Kwan-Lab/behavioral-rigs/photos/lickometer/lickometer complete assembly2.png

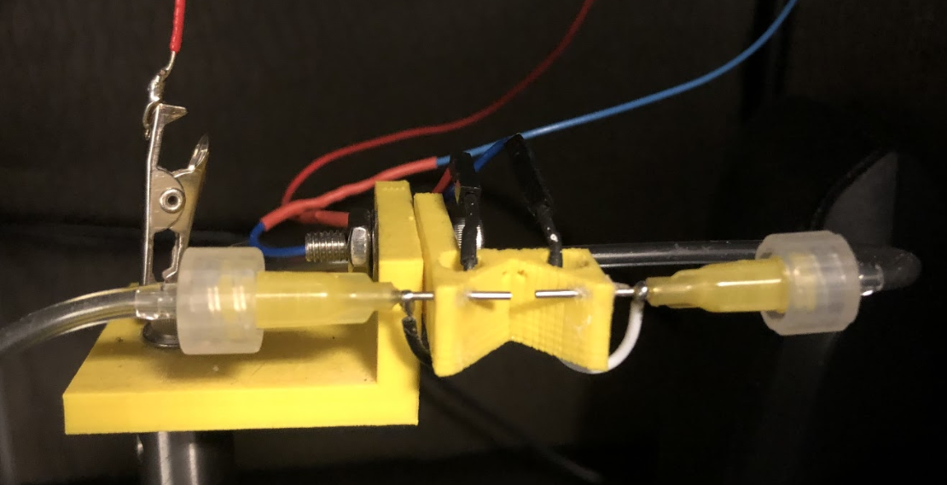
photos/lickometer/lickometer complete assembly2.png
