Kwan-Lab/behavioral-rigs/photos/lickometer/lickometer complete assembly.JPG

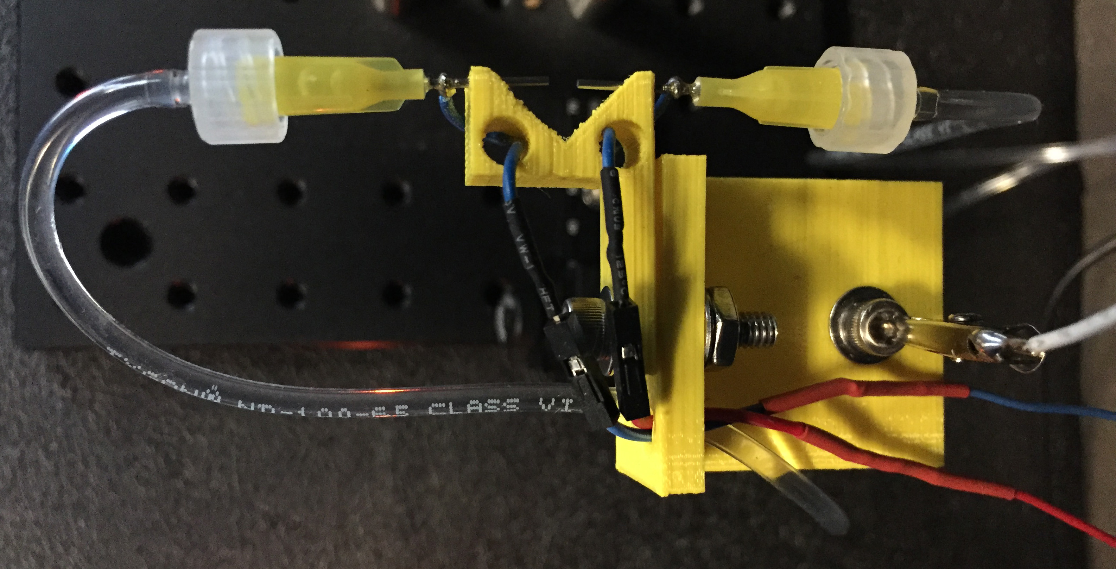
photos/lickometer/lickometer complete assembly.JPG
