Kwan-Lab/behavioral-rigs/README.md

# behavioral-rigs

This repository contains all the files needed to build a behavioral rig to train head-fixed mice for a two-choice decision-making task.
