Kwan-Lab/behavioral-rigs/photos/overview.pptx

Computer

Computer

Fluid
supply

USB-205
DAQ

USB-201
DAQ #2

USB-201
DAQ #1

USB-201
DAQ #3

Arduino

Solenoid
valves

Fluid delivery circuit

Lick
detection circuit

9V
battery

Steering
wheel

Lickometer

Grounding
clips

Pupil camera

Soundproof cabinet
