Kwan-Lab/behavioral-rigs/code/MATLAB pupil/Examples/daq/demo_clocked_dio/tmp102.png

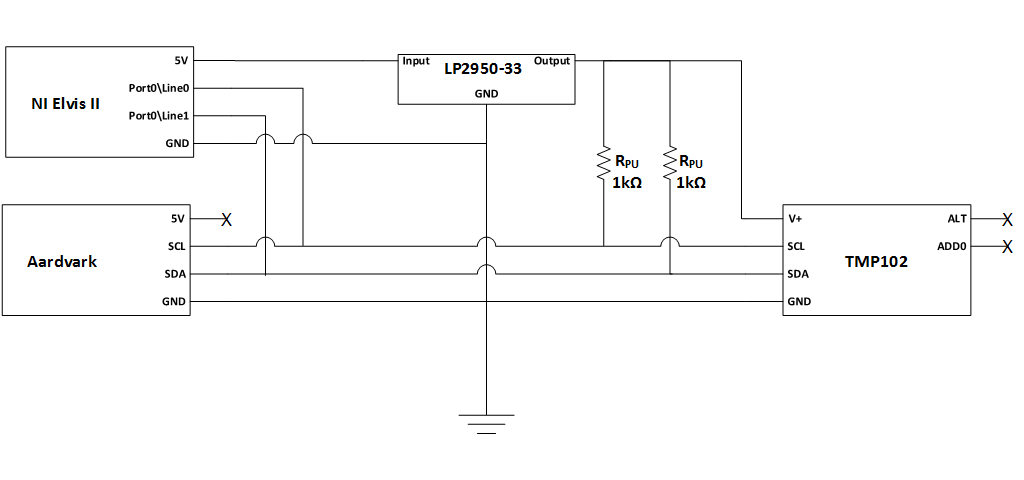
code/MATLAB pupil/Examples/daq/demo_clocked_dio/tmp102.png
