Kwan-Lab/behavioral-rigs/headplate/headplate1_small_window.jpg

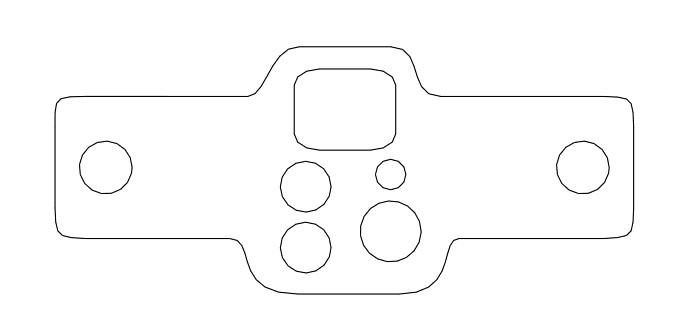
headplate/headplate1_small_window.jpg
