Kwan-Lab/behavioral-rigs/headplate/headplate2_standard.jpg

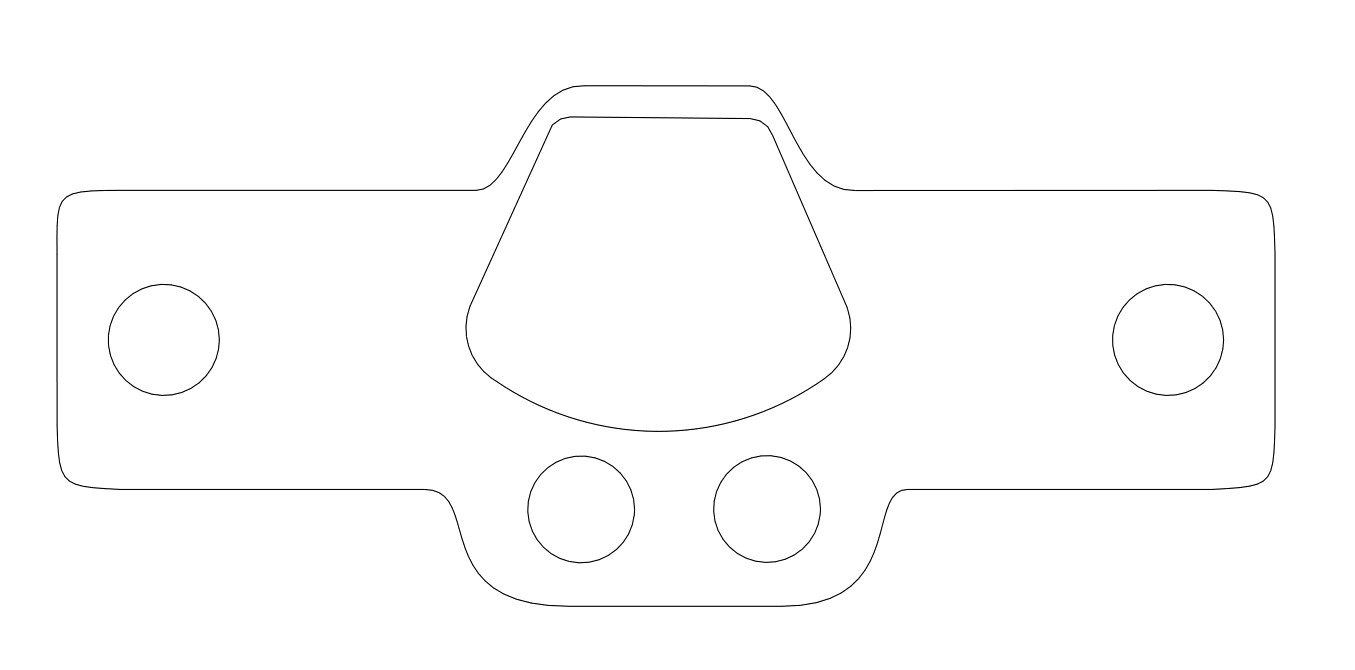
headplate/headplate2_standard.jpg
