Kwan-Lab/behavioral-rigs/headplate/headplate3_small_window_aligned.jpg

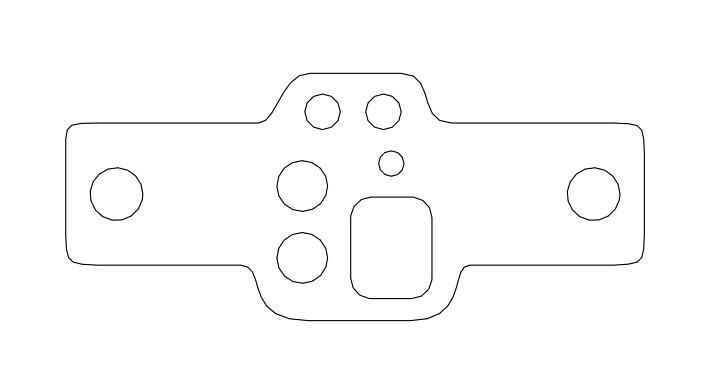
headplate/headplate3_small_window_aligned.jpg
