Kwan-Lab/behavioral-rigs/headplate/headplate4_wholecortex.jpg

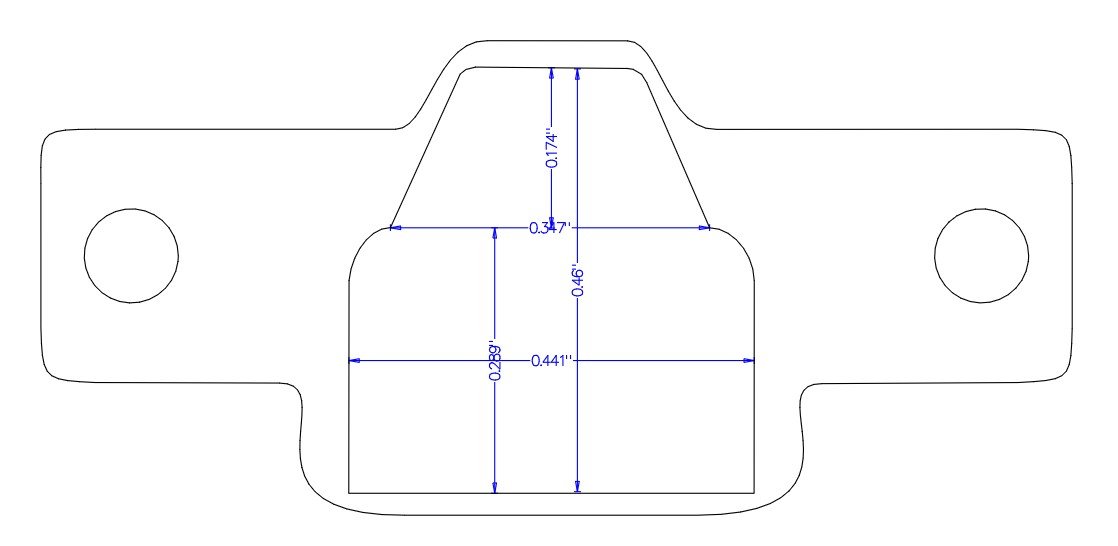
headplate/headplate4_wholecortex.jpg
