Kwan-Lab/behavioral-rigs/headplate/holder.jpg

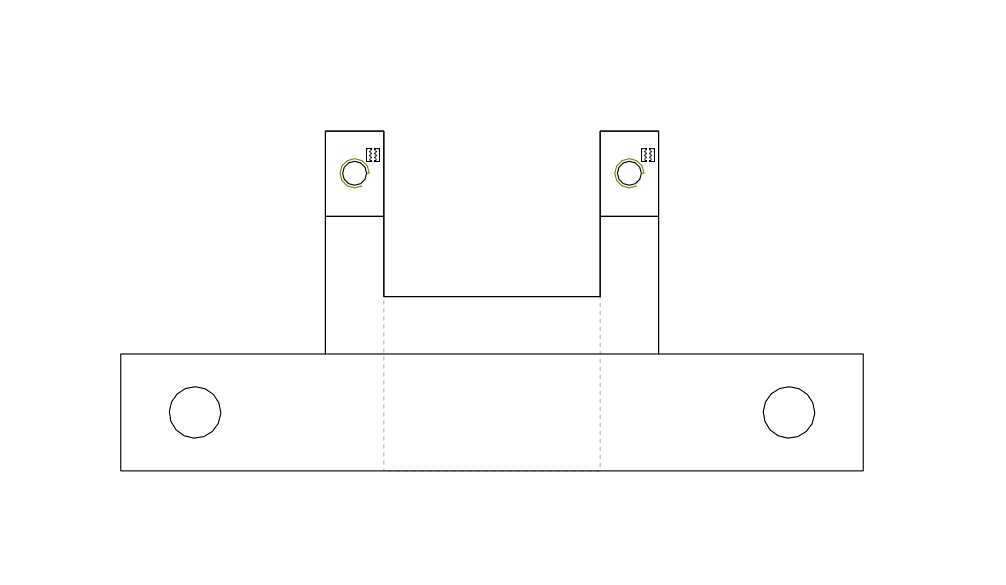
headplate/holder.jpg
