Kwan-Lab/behavioral-rigs/photos/box inside.JPG

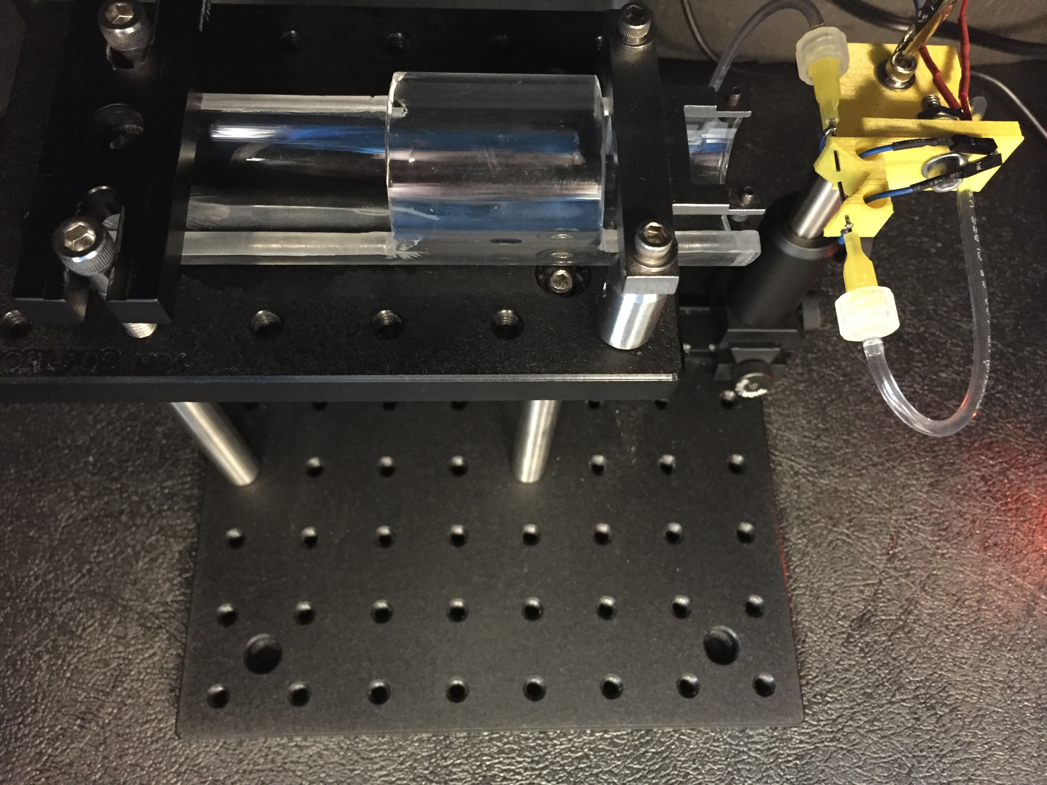
photos/box inside.JPG
