Kwan-Lab/behavioral-rigs/photos/box outside.JPG

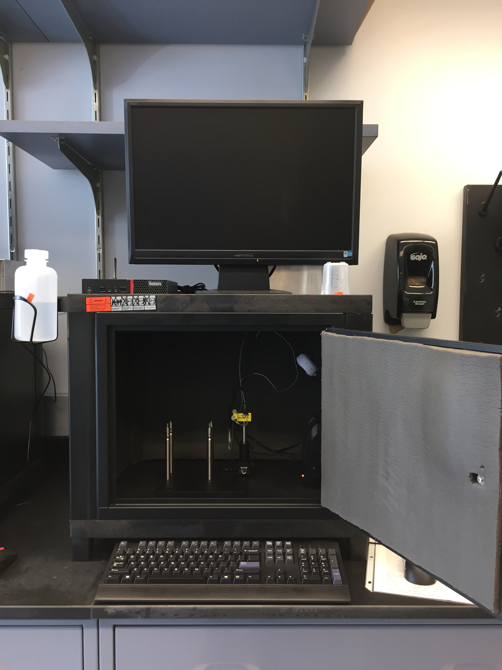
photos/box outside.JPG
