Kwan-Lab/behavioral-rigs/photos/cabinet/cabinet.JPG

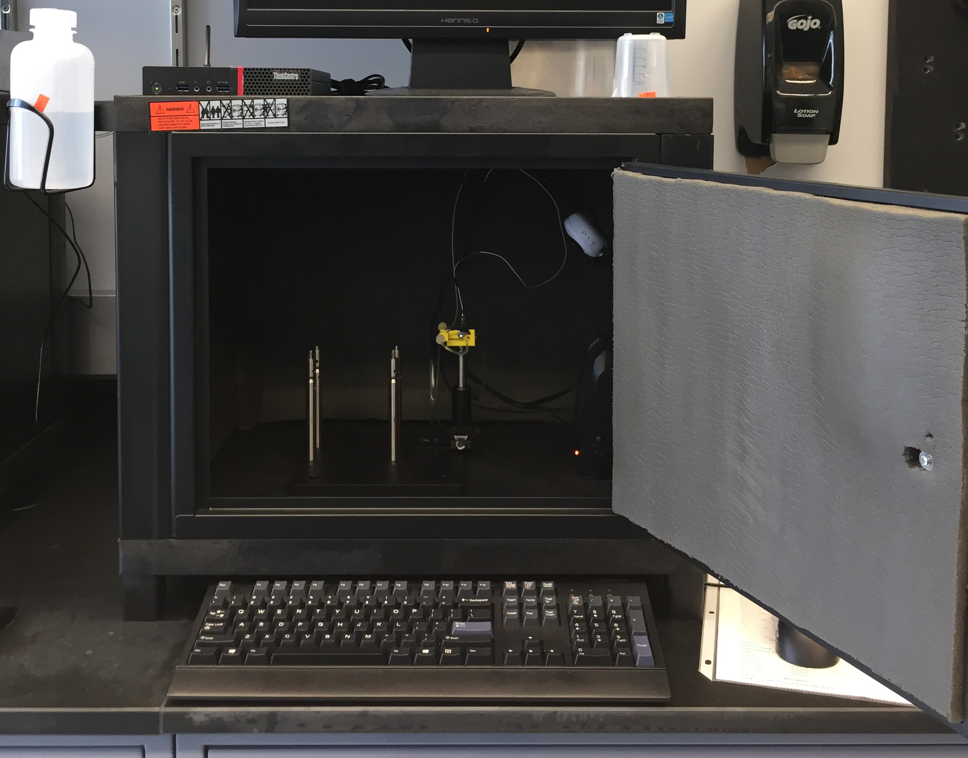
photos/cabinet/cabinet.JPG
