Kwan-Lab/behavioral-rigs/photos/cabinet/cart.png

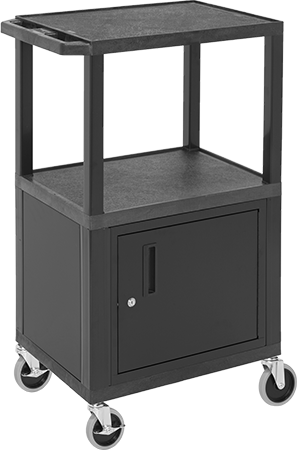
photos/cabinet/cart.png
