Kwan-Lab/behavioral-rigs/photos/computer control/camera.JPG

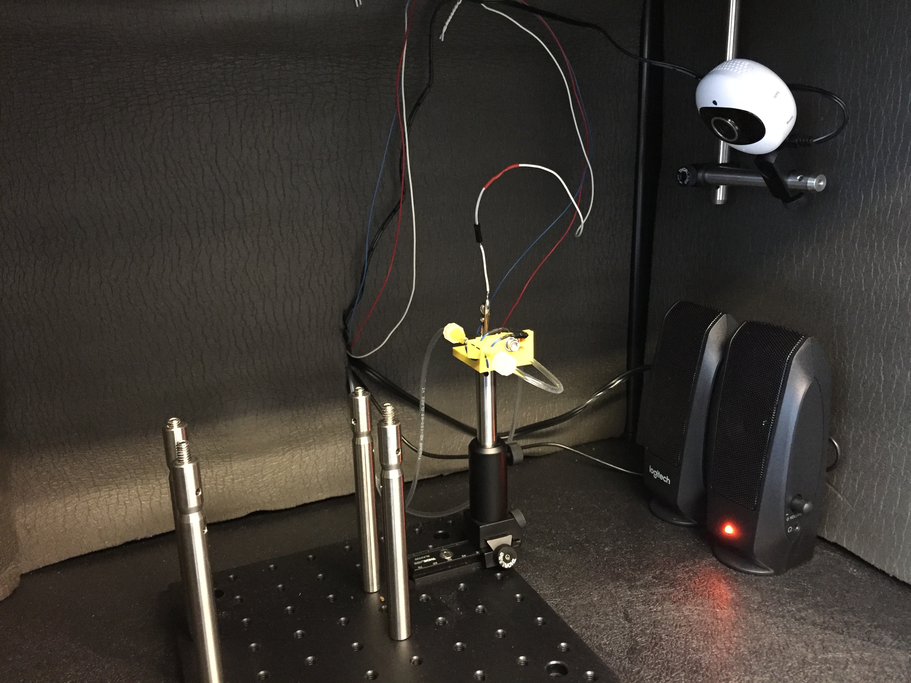
photos/computer control/camera.JPG
