Kwan-Lab/behavioral-rigs/photos/head fixation/acrylic.JPG

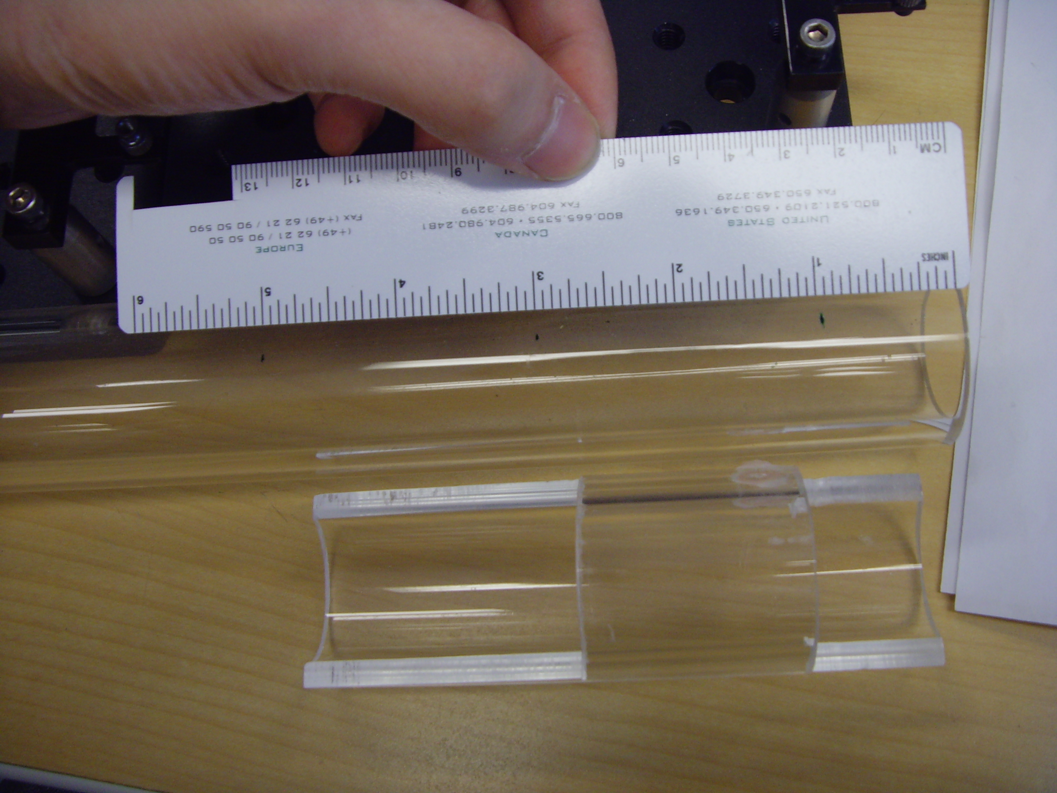
photos/head fixation/acrylic.JPG
