Kwan-Lab/behavioral-rigs/photos/head fixation/base empty.JPG

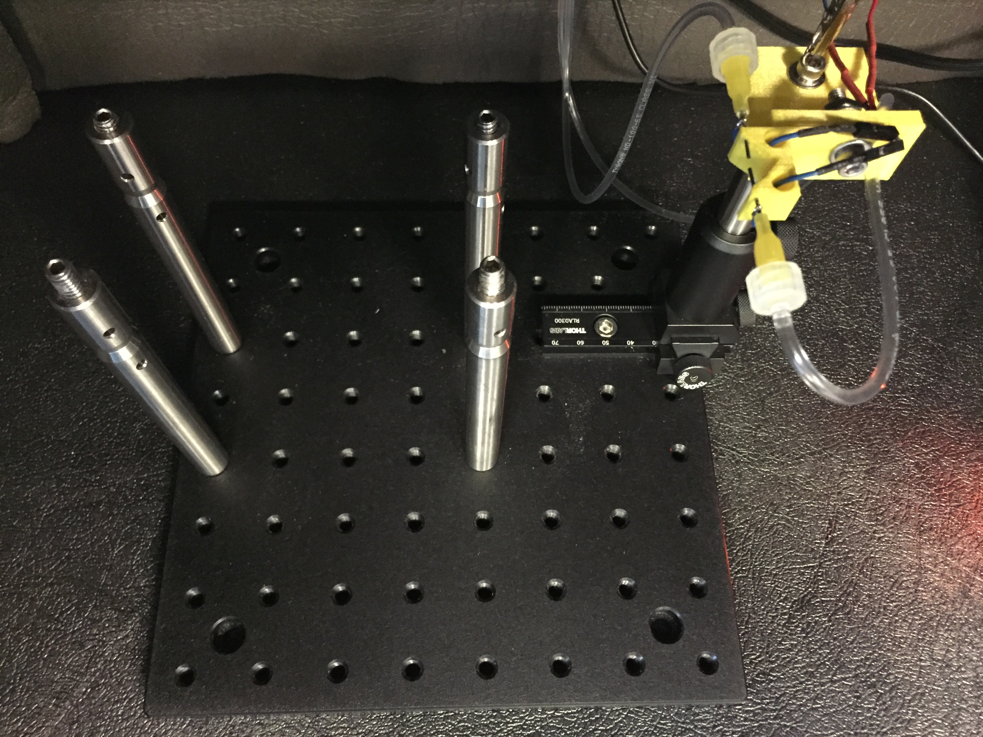
photos/head fixation/base empty.JPG
