Kwan-Lab/behavioral-rigs/photos/head fixation/headfixed front view.JPG

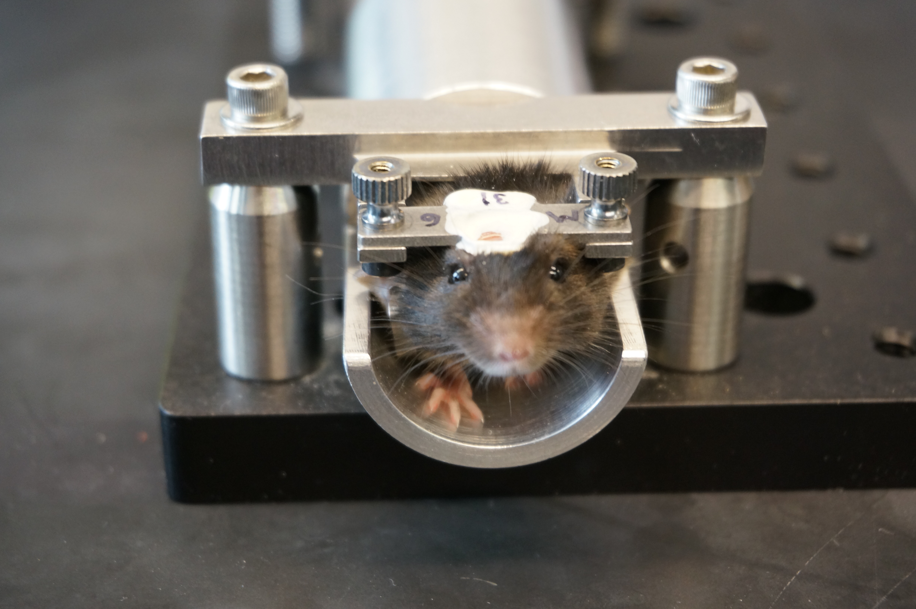
photos/head fixation/headfixed front view.JPG
