Kwan-Lab/behavioral-rigs/photos/head fixation/headfixed iso view.JPG

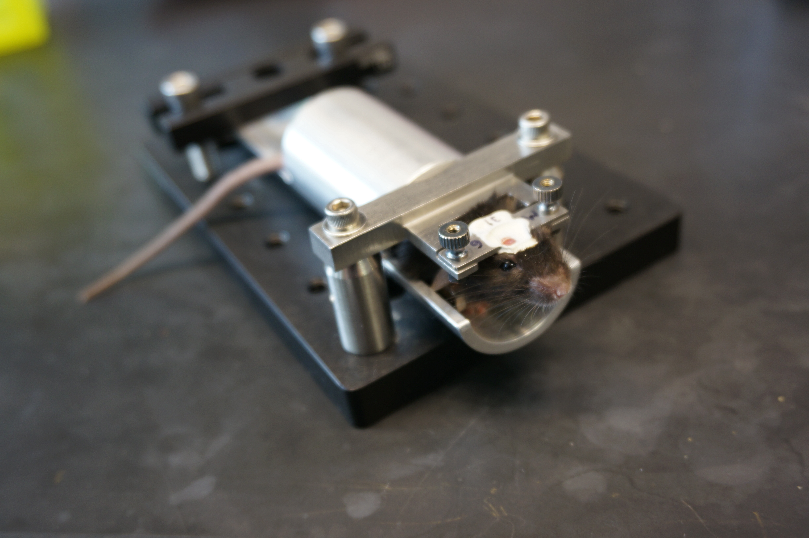
photos/head fixation/headfixed iso view.JPG
