Kwan-Lab/behavioral-rigs/photos/head fixation/headfixed top view.JPG

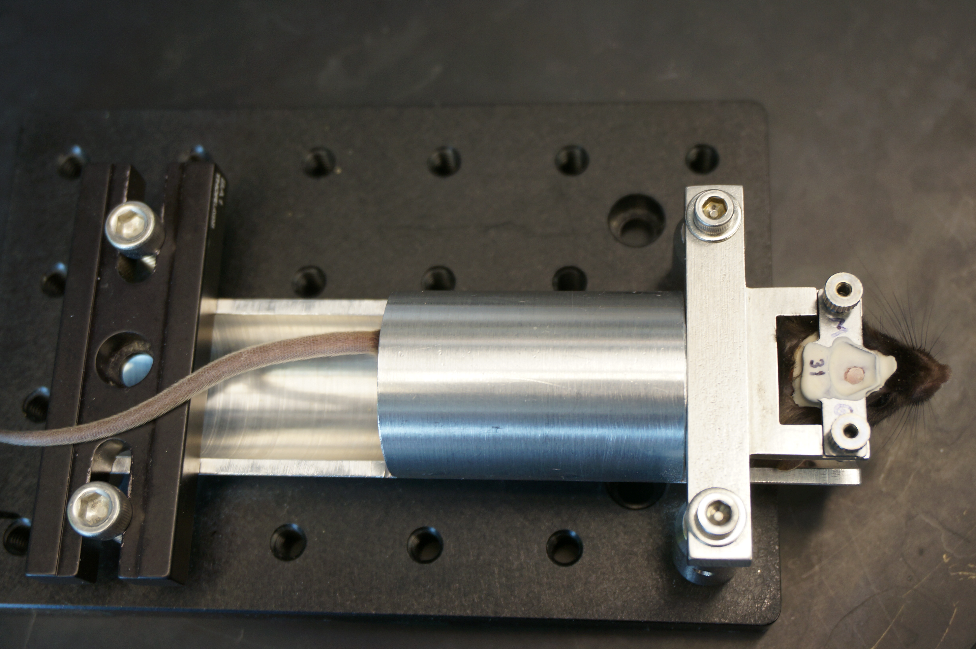
photos/head fixation/headfixed top view.JPG
