Kwan-Lab/behavioral-rigs/photos/lickometer/enclosure.JPG

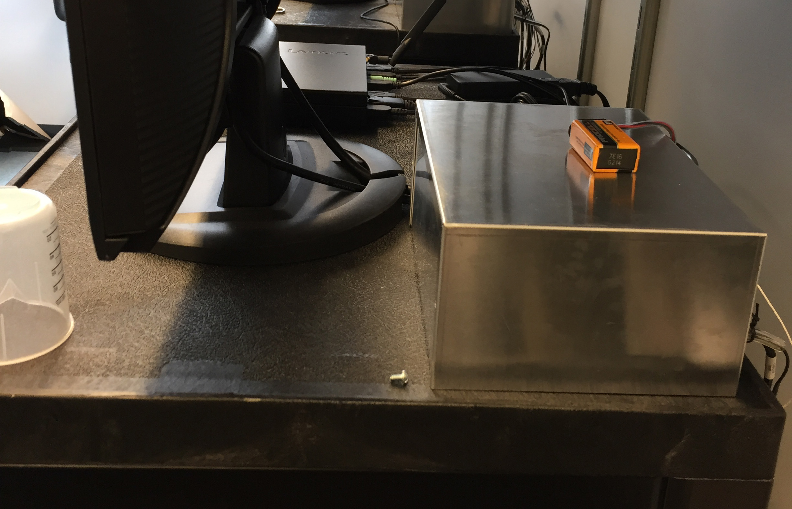
photos/lickometer/enclosure.JPG
