Kwan-Lab/behavioral-rigs/photos/lickometer/pcb lick-detector.jpg

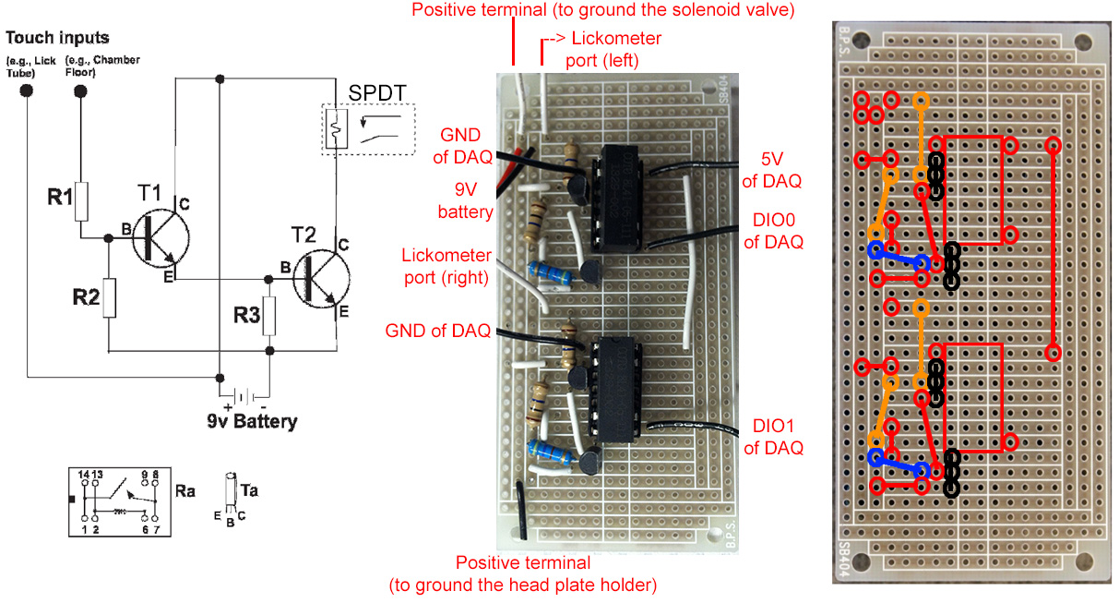
photos/lickometer/pcb lick-detector.jpg
