Kwan-Lab/behavioral-rigs/photos/lickometer/pcb solenoid-driver.jpg

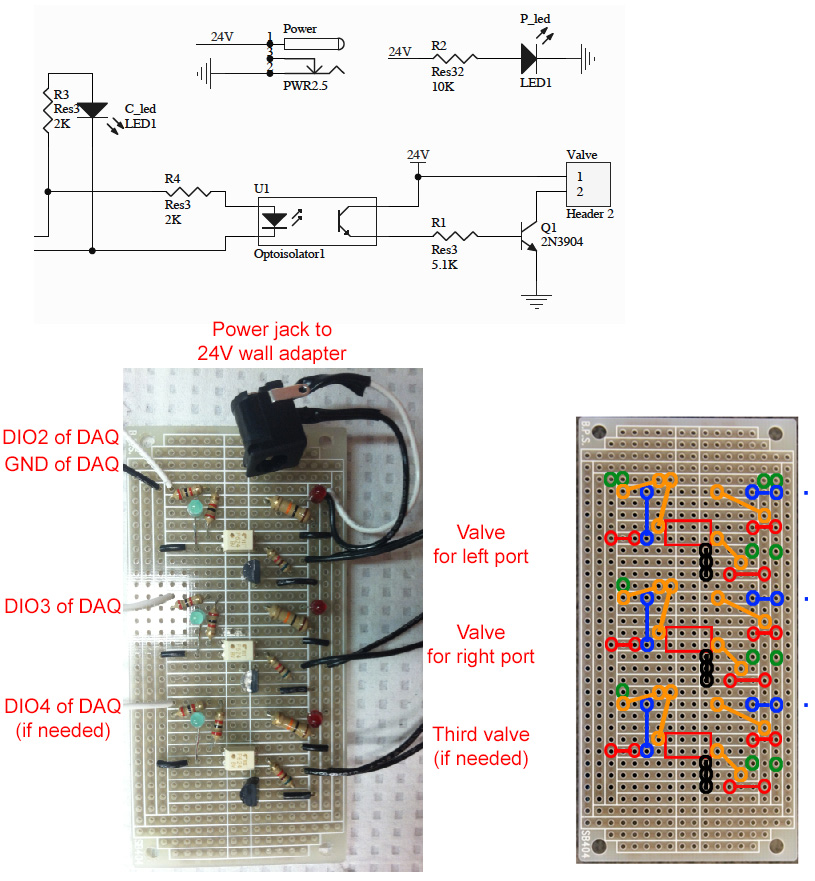
photos/lickometer/pcb solenoid-driver.jpg
