Kwan-Lab/behavioral-rigs/photos/lickometer/valve driver board.jpg

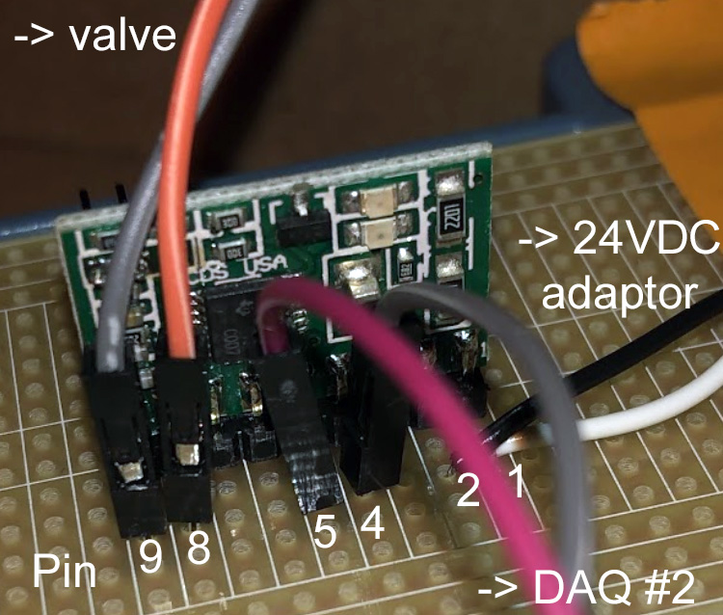
photos/lickometer/valve driver board.jpg
