Kwan-Lab/behavioral-rigs/photos/lickometer/valves.png

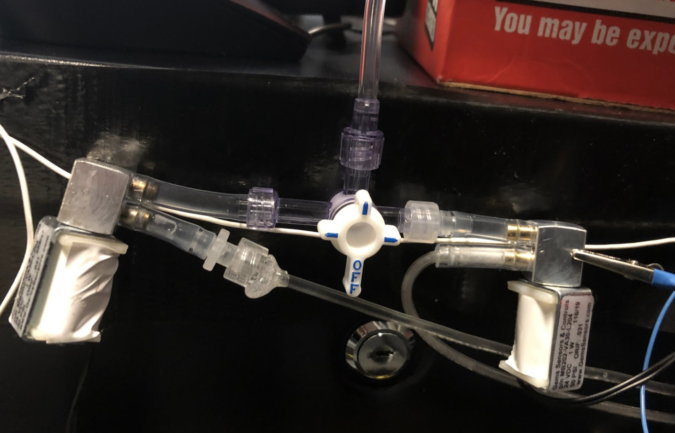
photos/lickometer/valves.png
