Kwan-Lab/behavioral-rigs/photos/lickometer/wire alligator.png

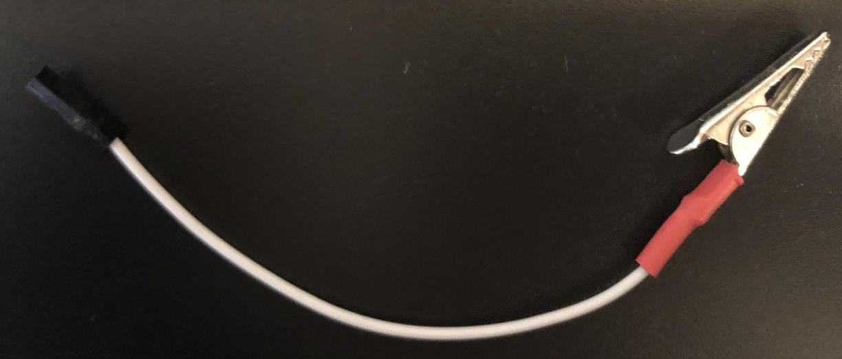
photos/lickometer/wire alligator.png
