Kwan-Lab/behavioral-rigs/photos/lickometer/wire syringe needle.png

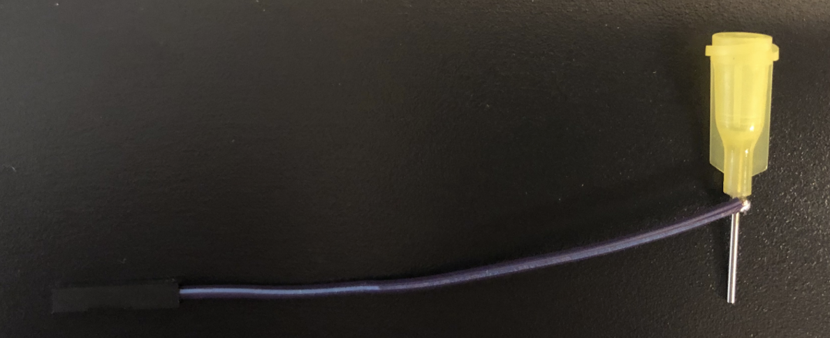
photos/lickometer/wire syringe needle.png
