Kwan-Lab/behavioral-rigs/photos/overview.png

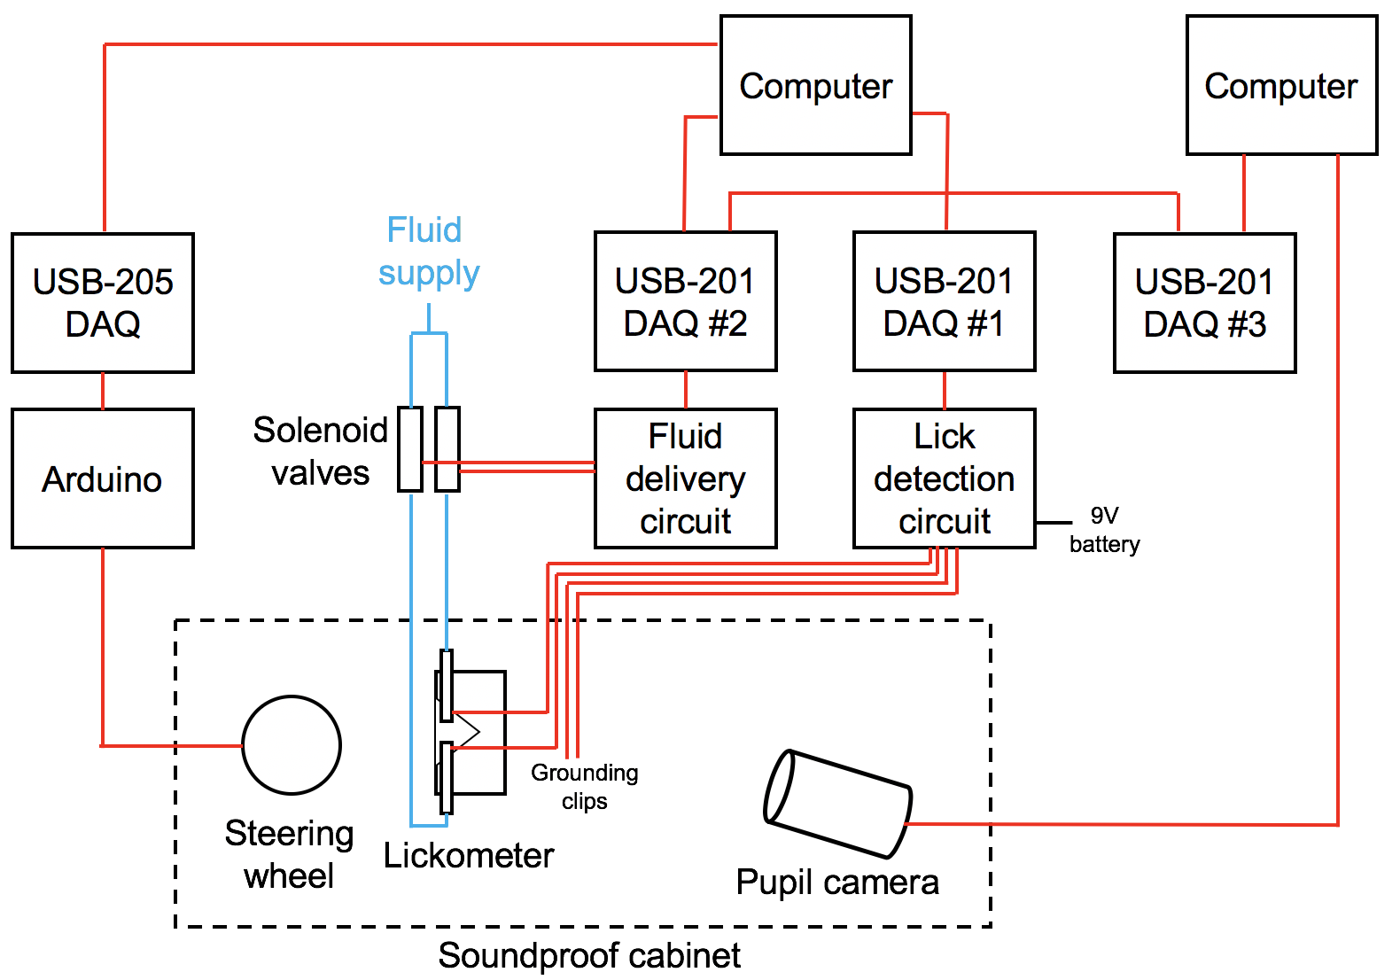
photos/overview.png
