Kwan-Lab/behavioral-rigs/photos/pupillometry/camera1.png

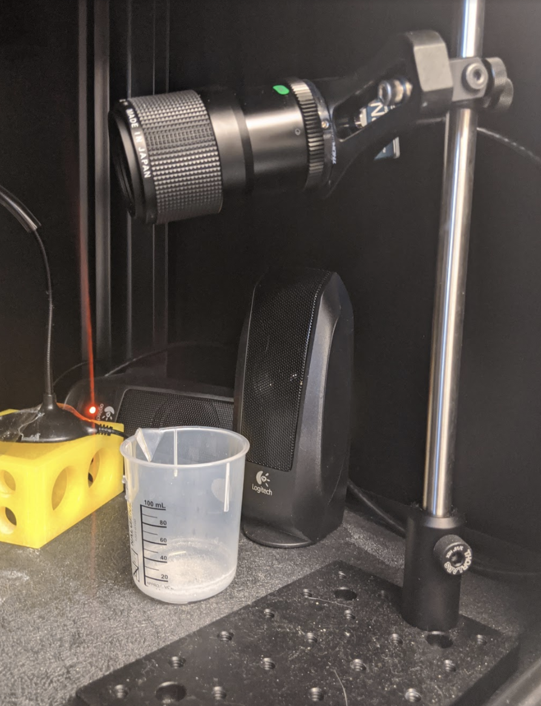
photos/pupillometry/camera1.png
