Kwan-Lab/behavioral-rigs/photos/pupillometry/camera2.png

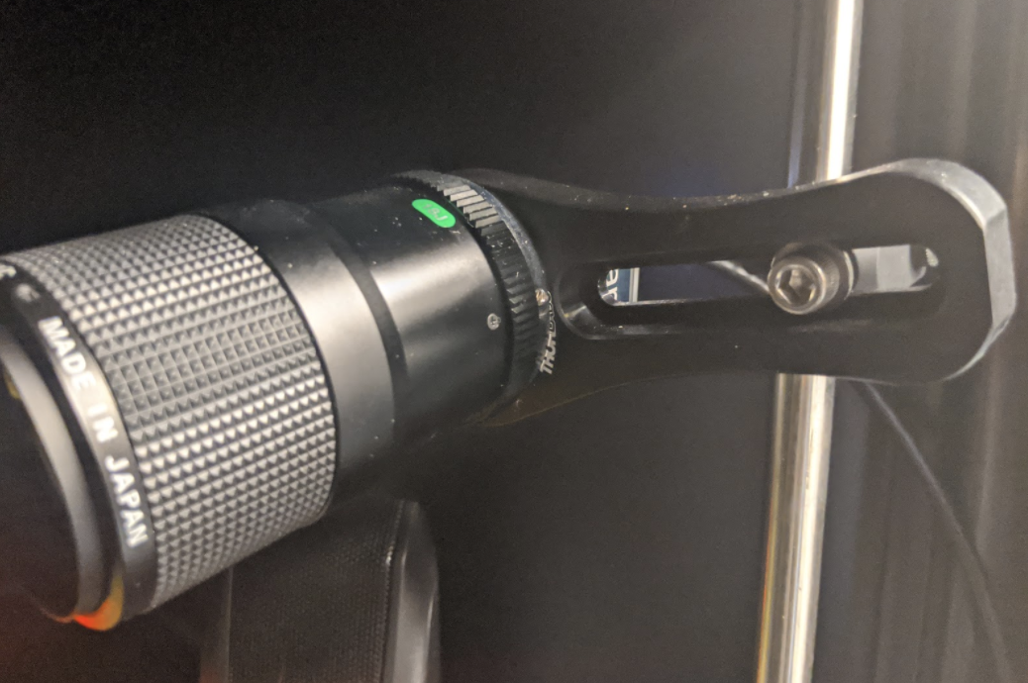
photos/pupillometry/camera2.png
