Kwan-Lab/behavioral-rigs/photos/pupillometry/camera3.png

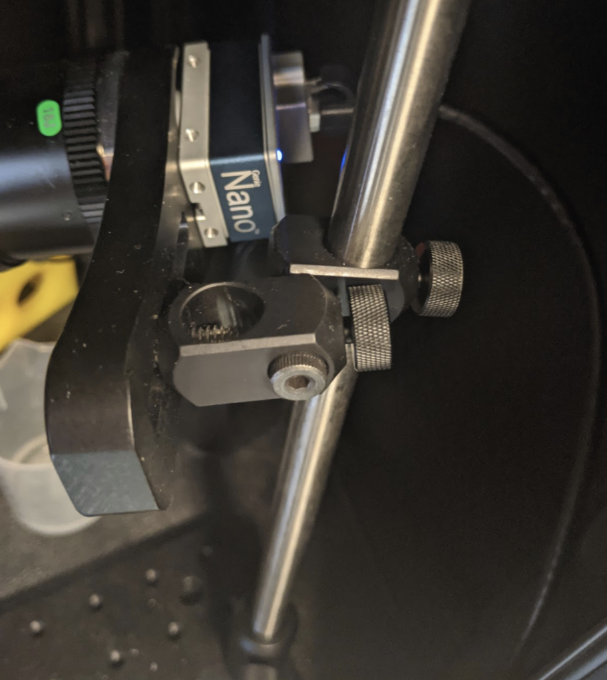
photos/pupillometry/camera3.png
