Kwan-Lab/behavioral-rigs/photos/pupillometry/illumination.png

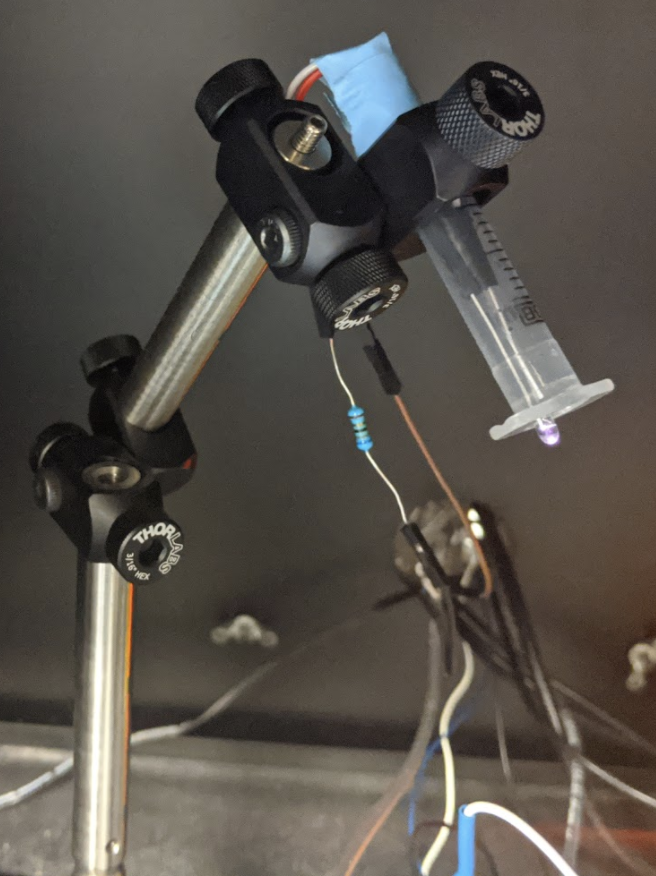
photos/pupillometry/illumination.png
