Kwan-Lab/behavioral-rigs/photos/pupillometry/pupil camera and lighting.JPG

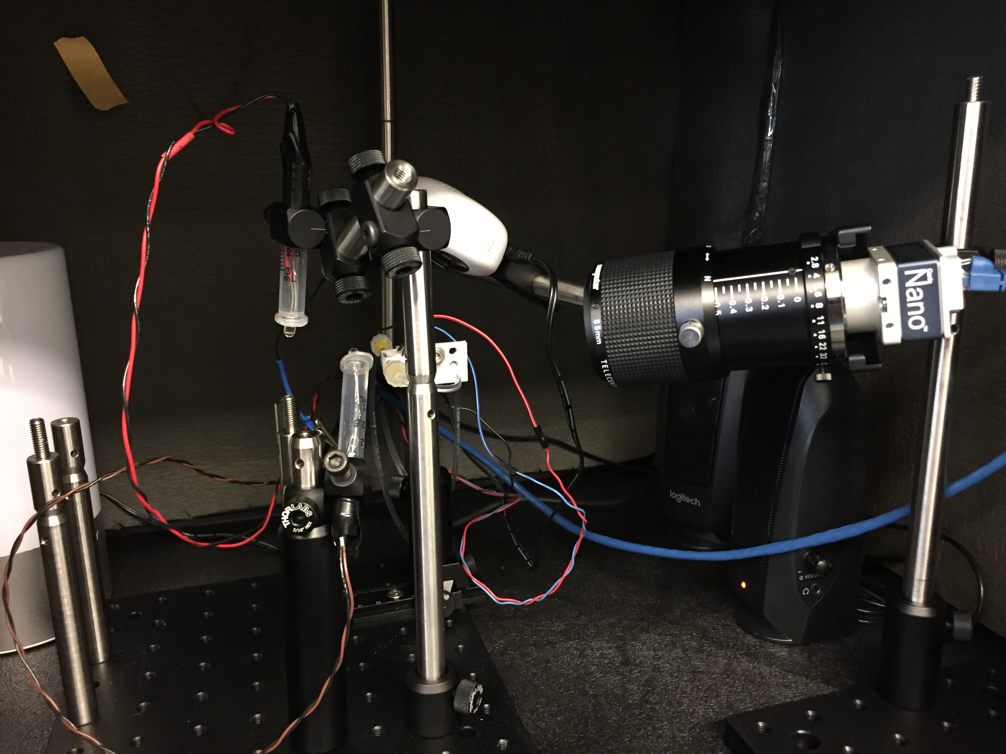
photos/pupillometry/pupil camera and lighting.JPG
