Kwan-Lab/behavioral-rigs/photos/pupillometry/pupil software.JPG

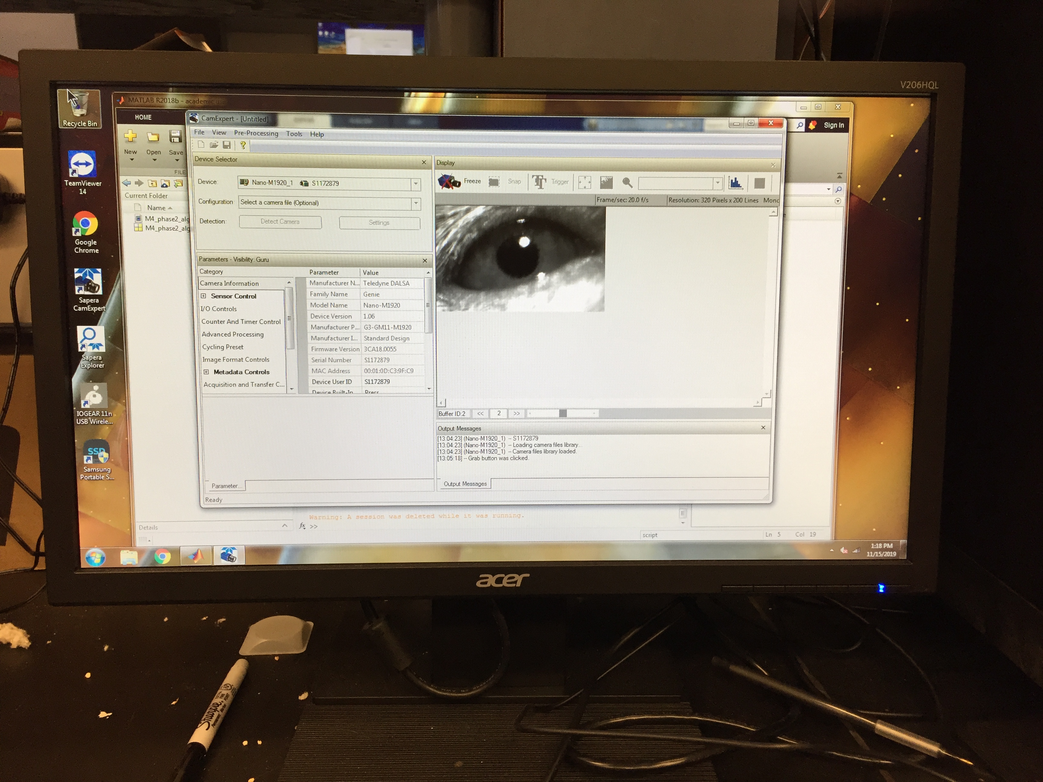
photos/pupillometry/pupil software.JPG
