Kwan-Lab/behavioral-rigs/photos/steering wheel/ardunio.png

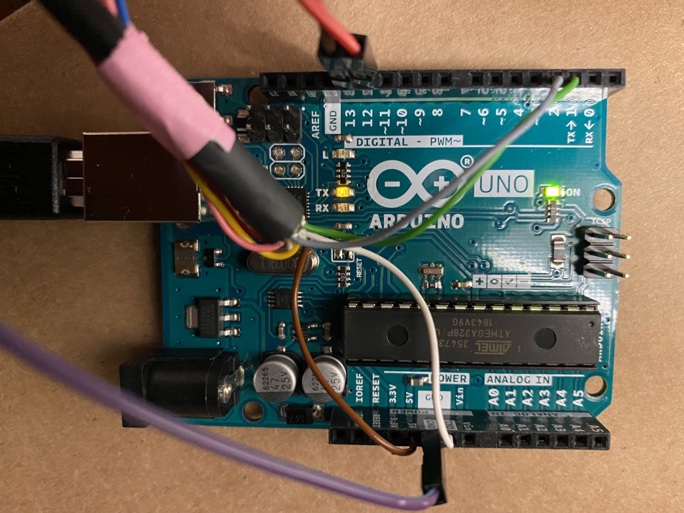
photos/steering wheel/ardunio.png
