Kwan-Lab/behavioral-rigs/photos/steering wheel/circuit.png

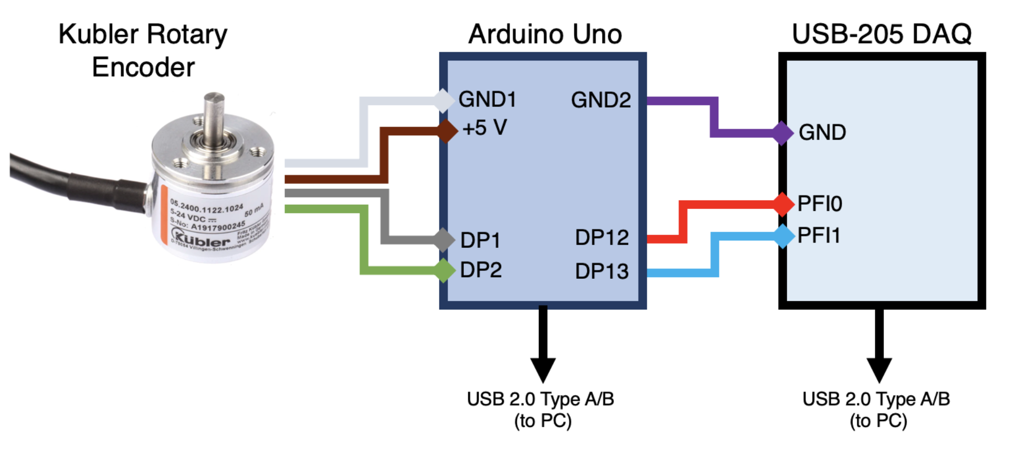
photos/steering wheel/circuit.png
