Kwan-Lab/behavioral-rigs/photos/steering wheel/encoder front-view.png

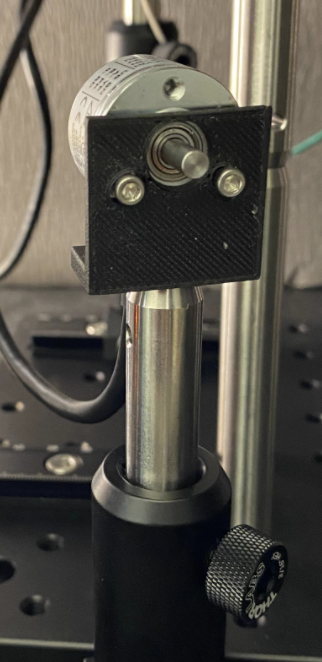
photos/steering wheel/encoder front-view.png
