Kwan-Lab/behavioral-rigs/photos/steering wheel/encoder side-view.png

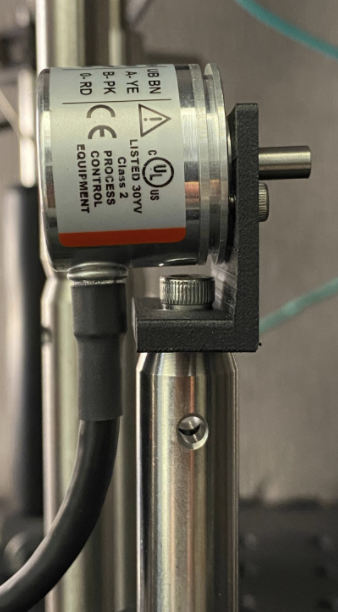
photos/steering wheel/encoder side-view.png
