Kwan-Lab/behavioral-rigs/photos/steering wheel/wheel only.png

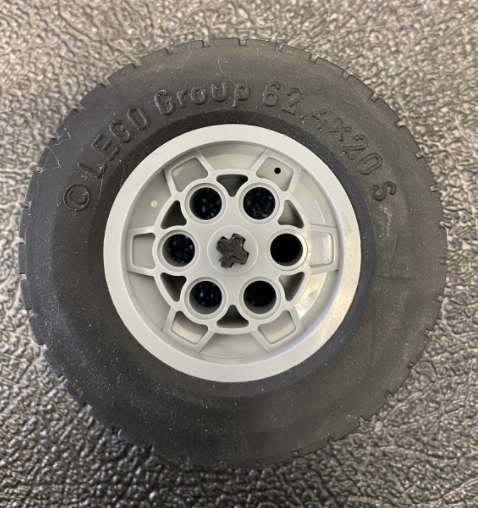
photos/steering wheel/wheel only.png
