Kwan-Lab/behavioral-rigs/photos/steering wheel/wheel system iso-view.png

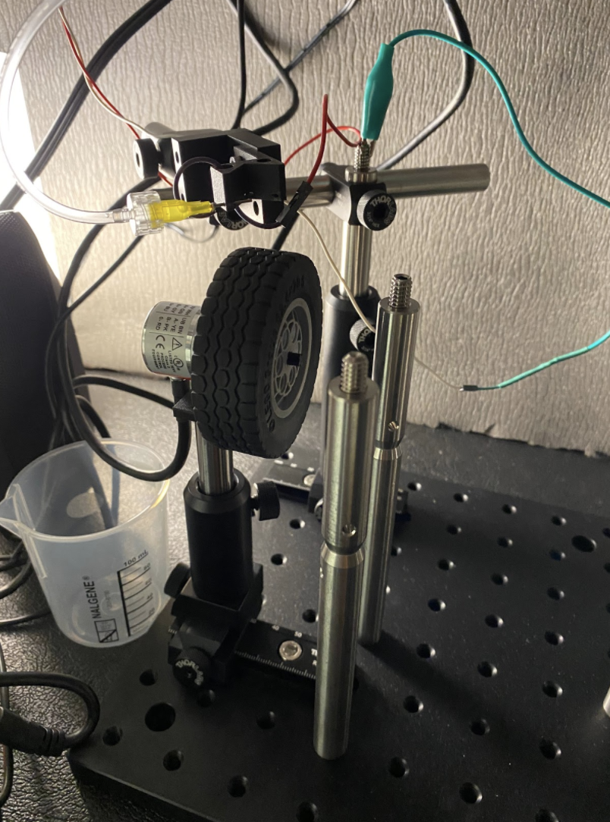
photos/steering wheel/wheel system iso-view.png
