Kwan-Lab/behavioral-rigs/photos/steering wheel/wheel system side-view.png

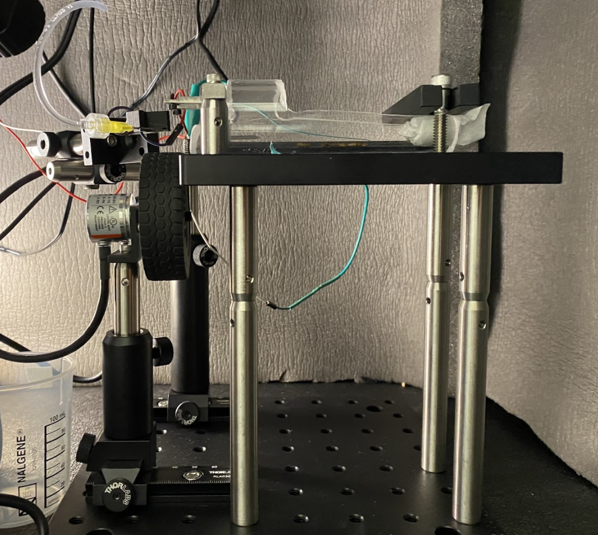
photos/steering wheel/wheel system side-view.png
