Kwan-Lab/behavioral-rigs/printed parts/Lickometer_Lpiece.png

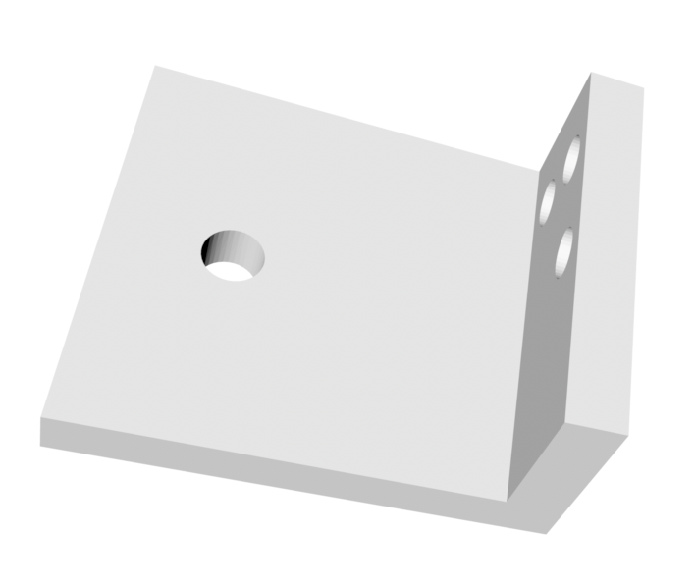
printed parts/Lickometer_Lpiece.png
