Kwan-Lab/behavioral-rigs/printed parts/Lickometer_Vpiece.png

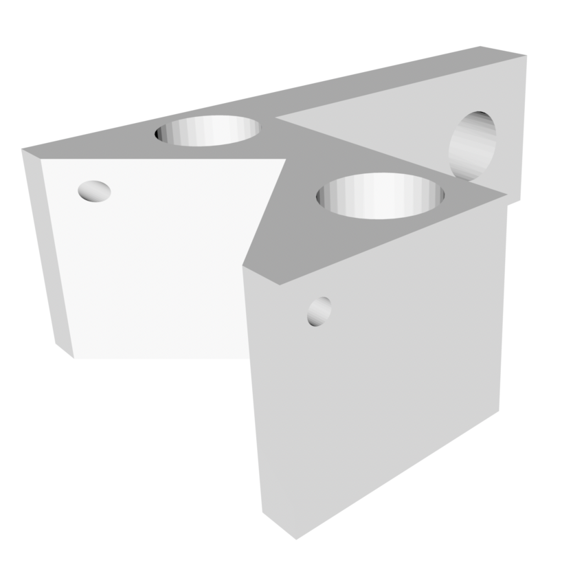
printed parts/Lickometer_Vpiece.png
