Kwan-Lab/behavioral-rigs/printed parts/WheelHolder.png

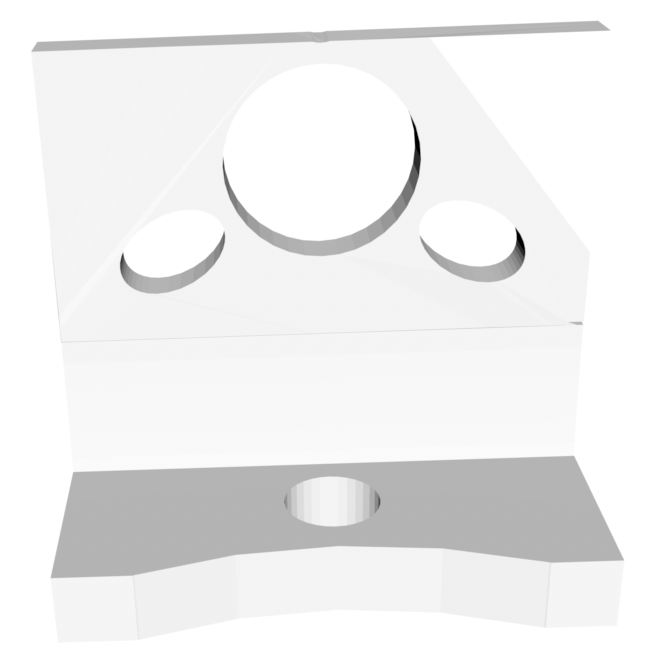
printed parts/WheelHolder.png
