Kwan-Lab/behavioral-rigs/printed parts/WheelShaftCoupler.png

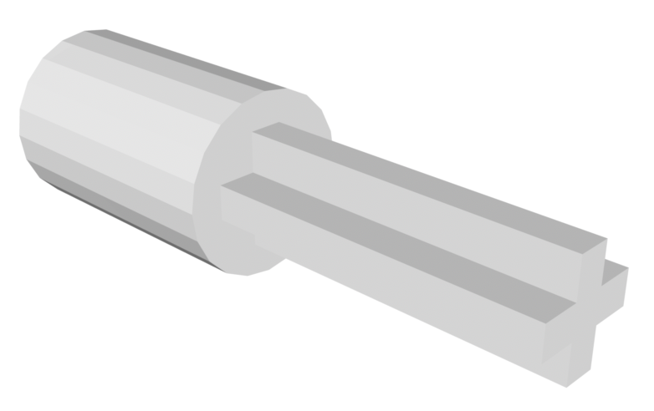
printed parts/WheelShaftCoupler.png
