Kwan-Lab/behavioral-rigs/printed parts/WheelHolder.STL

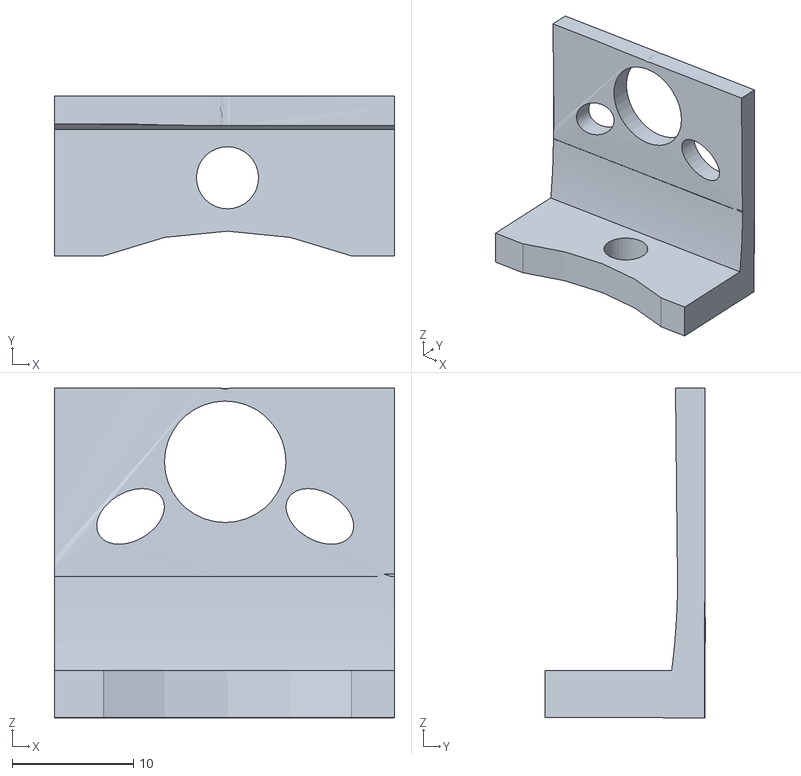
[picture p49: CAD file, 2020-04-09]
printed parts/WheelHolder.STL
28.0 x 13.2 x 27.2
