Kwan-Lab/behavioral-rigs/printed parts/Lickometer_Vpiece.STL

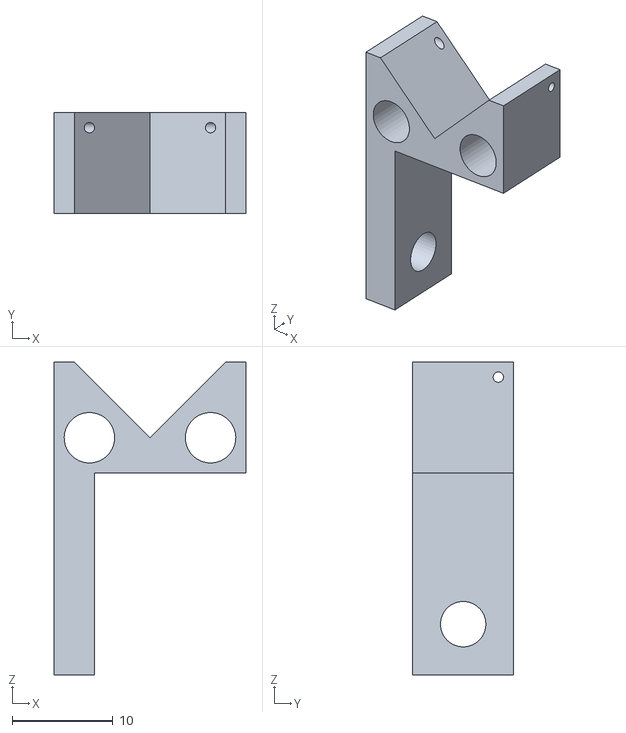
[picture p50: CAD file, 2020-04-09]
printed parts/Lickometer_Vpiece.STL
19.0 x 10.00 x 31.0
