Kwan-Lab/behavioral-rigs/printed parts/Lickometer_Lpiece.STL

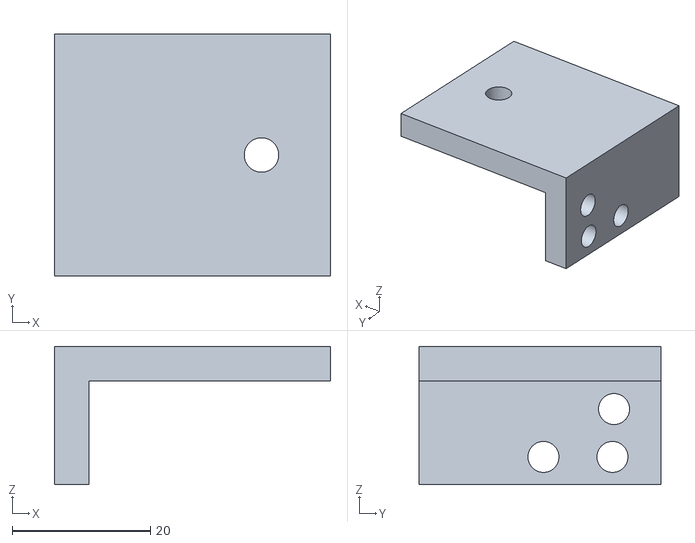
[picture p51: CAD file, 2020-04-09]
printed parts/Lickometer_Lpiece.STL
40.0 x 35.0 x 20.0
