Kwan-Lab/behavioral-rigs/printed parts/WheelShaftCoupler.stl

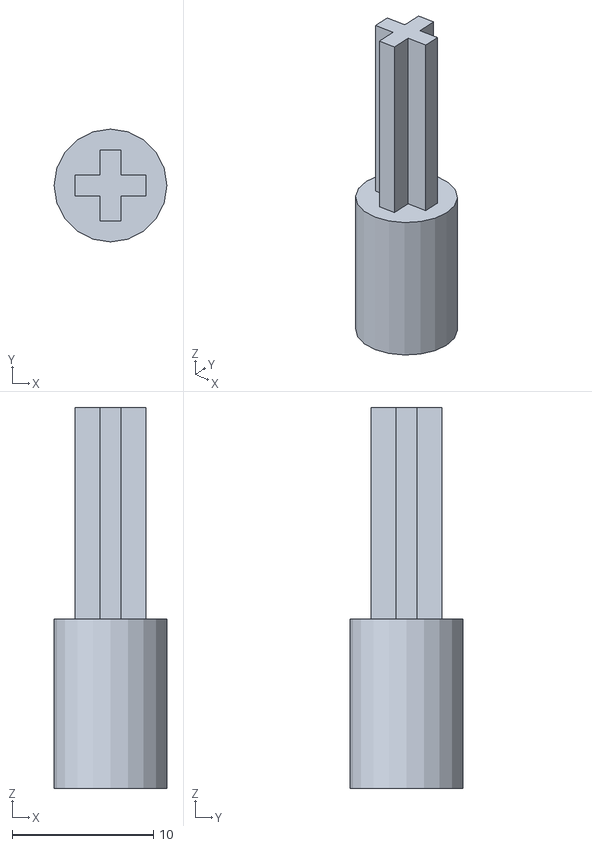
[picture p52: CAD file, 2020-04-09]
printed parts/WheelShaftCoupler.stl
8.00 x 8.00 x 27.0
