Kwan-Lab/behavioral-rigs/code/MATLAB pupil/Examples/daq/controlStepperMotor/controlStepperMotor_setup.png

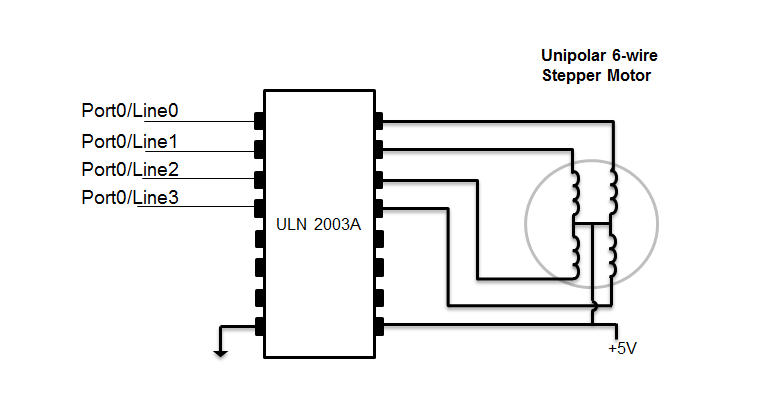
code/MATLAB pupil/Examples/daq/controlStepperMotor/controlStepperMotor_setup.png
